IchiroKawashima/LSI-Design-Contest-2019/(threads)

Thread 15 (2019-02-01):

荷重値のクリッピング処理時のビット幅

IchiroKawashima, 2019-02-01:
https://github.com/IchiroKawashima/LSI-Design-Contest-2019/blob/edfe113395e68d94f4d649f5600b7f1a6fbd2dda/src/Network/Element/BiasWeight.v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

`w_weight`のビット幅と`w_weight_clp`のビット幅が逆になっている．

Closed 2019-02-01.

Thread 16 (2019-02-09):

Invalid bitwidth in Test modules

IchiroKawashima, 2019-02-09:
https://github.com/IchiroKawashima/LSI-Design-Contest-2019/blob/87d925d65bb4008e688236b019547710cd2cedb8/test/StreamSource.v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

https://github.com/IchiroKawashima/LSI-Design-Contest-2019/blob/87d925d65bb4008e688236b019547710cd2cedb8/test/StreamSink.v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

適切なビット幅は`[$clog2(SIZE+1)-1:0]`である．
