IchiroKawashima/LSI-Design-Contest-2019/src/Network/Layer/HiddenLayer.v

module HiddenLayer #
( parameter NP    = 8
, parameter NC    = 7
, parameter NN    = 6
, parameter WV    = 5
, parameter SEED  = 123456789
, parameter BURST = "yes"
)
( input                 iMode
, input        [WV-1:0] iLR
, input                 iValid_AM_State0
, output                oReady_AM_State0
, input     [NP*WV-1:0] iData_AM_State0
, input                 iValid_AS_State1
, output                oReady_AS_State1
, input     [NP*WV-1:0] iData_AS_State1
, output                oValid_BM_State0
, input                 iReady_BM_State0
, output    [NC*WV-1:0] oData_BM_State0
, output                oValid_BM_State1
, input                 iReady_BM_State1
, output    [NC*WV-1:0] oData_BM_State1
, input                 iValid_AM_Weight
, output                oReady_AM_Weight
, input  [NC*NN*WV-1:0] iData_AM_Weight
, output                oValid_BM_Weight
, input                 iReady_BM_Weight
, output [NP*NC*WV-1:0] oData_BM_Weight
, input                 iValid_AM_Delta0
, output                oReady_AM_Delta0
, input     [NN*WV-1:0] iData_AM_Delta0
, output                oValid_BM_Delta0
, input                 iReady_BM_Delta0
, output    [NC*WV-1:0] oData_BM_Delta0
, input                 iRST
, input                 iCLK
);

wire                            wvld_Accum0;
wire                            wrdy_Accum0;
wire [NC*($clog2(NP)+1+WV)-1:0] wdata_Accum0;
wire                            wvld_Accum1;
wire                            wrdy_Accum1;
wire [NC*($clog2(NP)+1+WV)-1:0] wdata_Accum1;
wire                            wvld_Accum2;
wire                            wrdy_Accum2;
wire   [NC*($clog2(NN)+WV)-1:0] wdata_Accum2;
wire                            wvld_WeightBias;
wire                            wrdy_WeightBias;
wire       [NC*NP*WV+NC*WV-1:0] wdata_WeightBias;
wire                            wvld_Delta1;
wire                            wrdy_Delta1;
wire                [NC*WV-1:0] wdata_Delta1;

ForwardMaccum #
( .NP(NP)
, .NC(NC)
, .WV(WV)
, .BURST(BURST)
) fm
( .iMode(iMode)
, .iValid_AM_WeightBias(wvld_WeightBias)
, .oReady_AM_WeightBias(wrdy_WeightBias)
, .iData_AM_WeightBias(wdata_WeightBias)
, .iValid_AM_State0(iValid_AM_State0)
, .oReady_AM_State0(oReady_AM_State0)
, .iData_AM_State0(iData_AM_State0)
, .oValid_BM_Accum0(wvld_Accum0)
, .iReady_BM_Accum0(wrdy_Accum0)
, .oData_BM_Accum0(wdata_Accum0)
, .oValid_BM_Accum1(wvld_Accum1)
, .iReady_BM_Accum1(wrdy_Accum1)
, .oData_BM_Accum1(wdata_Accum1)
, .iRST(iRST)
, .iCLK(iCLK)
);

Neuron #
( .HIDDEN("yes")
, .NP(NP)
, .NC(NC)
, .WV(WV)
, .BURST(BURST)
) ne
( .iMode(iMode)
, .iValid_AM_Accum0(wvld_Accum0)
, .oReady_AM_Accum0(wrdy_Accum0)
, .iData_AM_Accum0(wdata_Accum0)
, .oValid_BM_State0(oValid_BM_State0)
, .iReady_BM_State0(iReady_BM_State0)
, .oData_BM_State0(oData_BM_State0)
, .oValid_BM_State1(oValid_BM_State1)
, .iReady_BM_State1(iReady_BM_State1)
, .oData_BM_State1(oData_BM_State1)
, .iRST(iRST)
, .iCLK(iCLK)
);

BiasWeight #
( .NP(NP)
, .NC(NC)
, .WV(WV)
, .BURST(BURST)
, .SEED(SEED)
) bw
( .iMode(iMode)
, .iLR(iLR)
, .iValid_AS_State1(iValid_AS_State1)
, .oReady_AS_State1(oReady_AS_State1)
, .iData_AS_State1(iData_AS_State1)
, .iValid_AS_Delta1(wvld_Delta1)
, .oReady_AS_Delta1(wrdy_Delta1)
, .iData_AS_Delta1(wdata_Delta1)
, .oValid_BM_WeightBias(wvld_WeightBias)
, .iReady_BM_WeightBias(wrdy_WeightBias)
, .oData_BM_WeightBias(wdata_WeightBias)
, .oValid_BM_Weight(oValid_BM_Weight)
, .iReady_BM_Weight(iReady_BM_Weight)
, .oData_BM_Weight(oData_BM_Weight)
, .iRST(iRST)
, .iCLK(iCLK)
);

Delta #
( .HIDDEN("yes")
, .NP(NP)
, .NC(NC)
, .NN(NN)
, .WV(WV)
, .BURST(BURST)
) de
( .iValid_AS_Accum1(wvld_Accum1)
, .oReady_AS_Accum1(wrdy_Accum1)
, .iData_AS_Accum1(wdata_Accum1)
, .iValid_AS_Accum2(wvld_Accum2)
, .oReady_AS_Accum2(wrdy_Accum2)
, .iData_AS_Accum2(wdata_Accum2)
, .oValid_BM_Delta0(oValid_BM_Delta0)
, .iReady_BM_Delta0(iReady_BM_Delta0)
, .oData_BM_Delta0(oData_BM_Delta0)
, .oValid_BM_Delta1(wvld_Delta1)
, .iReady_BM_Delta1(wrdy_Delta1)
, .oData_BM_Delta1(wdata_Delta1)
, .iRST(iRST)
, .iCLK(iCLK)
);

BackwardMaccum #
( .NN(NN)
, .NC(NC)
, .WV(WV)
, .BURST(BURST)
) bm
( .iValid_AM_Weight(iValid_AM_Weight)
, .oReady_AM_Weight(oReady_AM_Weight)
, .iData_AM_Weight(iData_AM_Weight)
, .iValid_AM_Delta0(iValid_AM_Delta0)
, .oReady_AM_Delta0(oReady_AM_Delta0)
, .iData_AM_Delta0(iData_AM_Delta0)
, .oValid_BM_Accum2(wvld_Accum2)
, .iReady_BM_Accum2(wrdy_Accum2)
, .oData_BM_Accum2(wdata_Accum2)
, .iRST(iRST)
, .iCLK(iCLK)
);

endmodule
