IchiroKawashima/LSI-Design-Contest-2019/test/Basic/CollectorTest.v

`include "Test.vh"

module CollectorTest #
( parameter BURST    = "no"
, parameter PRIORITY = 0
);

ClockDomain c();

reg        iValid_AM0;
wire       oReady_AM0;
reg  [3:0] iData_AM0;
reg        iValid_AM1;
wire       oReady_AM1;
reg  [3:0] iData_AM1;
wire       oValid_BM;
reg        iReady_BM;
wire       oSelect_BM;
wire [7:0] oData_BM;

wire       wvld0;
wire       wrdy0;
wire [3:0] wdata0;
wire       wvld1;
wire       wrdy1;
wire [3:0] wdata1;

//Register
Register #
( .WIDTH(4)
, .BURST(BURST)
) rg0
( .iValid_AM(iValid_AM0)
, .oReady_AM(oReady_AM0)
, .iData_AM(iData_AM0)
, .oValid_BM(wvld0)
, .iReady_BM(wrdy0)
, .oData_BM(wdata0)
, .iRST(c.RST)
, .iCLK(c.CLK)
);

//Register
Register #
( .WIDTH(4)
, .BURST(BURST)
) rg1
( .iValid_AM(iValid_AM1)
, .oReady_AM(oReady_AM1)
, .iData_AM(iData_AM1)
, .oValid_BM(wvld1)
, .iReady_BM(wrdy1)
, .oData_BM(wdata1)
, .iRST(c.RST)
, .iCLK(c.CLK)
);

Collector #
( .WIDTH0(4)
, .WIDTH1(4)
, .PRIORITY(PRIORITY)
) collector
( .iValid_AS0(wvld0)
, .oReady_AS0(wrdy0)
, .iData_AS0(wdata0)
, .iValid_AS1(wvld1)
, .oReady_AS1(wrdy1)
, .iData_AS1(wdata1)
, .oValid_BM(oValid_BM)
, .iReady_BM(iReady_BM)
, .oSelect_BM(oSelect_BM)
, .oData_BM(oData_BM)
);

`DUMP_ALL("cl.vcd")
`SET_LIMIT(c, 30)

initial begin
    @(c.eCLK) begin
        iValid_AM0 = 1'b0;
        iValid_AM1 = 1'b0;
        iData_AM0  = 4'h0;
        iData_AM1  = 4'h0;
        iReady_BM  = 1'b0;
    end

    //Case0
    @(c.eCLK) begin
        iValid_AM0 = 1'b1;
        iValid_AM1 = 1'b0;
        iData_AM0  = 4'ha;
        iData_AM1  = 4'h0;
        iReady_BM  = 1'b1;
    end

    @(c.eCLK) begin
        iValid_AM0 = 1'b0;
        iValid_AM1 = 1'b0;
        iData_AM0  = 4'h0;
        iData_AM1  = 4'h0;
        iReady_BM  = 1'b1;
    end

    `WAIT_UNTIL(c, oReady_AM0 === 1'b1 && oReady_AM1 === 1'b1)

    //Case1
    @(c.eCLK) begin
        iValid_AM0 = 1'b0;
        iValid_AM1 = 1'b1;
        iData_AM0  = 4'h0;
        iData_AM1  = 4'hb;
        iReady_BM  = 1'b1;
    end

    @(c.eCLK) begin
        iValid_AM0 = 1'b0;
        iValid_AM1 = 1'b0;
        iData_AM0  = 4'h0;
        iData_AM1  = 4'h0;
        iReady_BM  = 1'b1;
    end

    `WAIT_UNTIL(c, oReady_AM0 === 1'b1 && oReady_AM1 === 1'b1)

    //Case2
    @(c.eCLK) begin
        iValid_AM0 = 1'b1;
        iValid_AM1 = 1'b1;
        iData_AM0  = 4'h7;
        iData_AM1  = 4'h8;
        iReady_BM  = 1'b0;
    end

    @(c.eCLK) begin
        iValid_AM0 = 1'b0;
        iValid_AM1 = 1'b0;
        iData_AM0  = 4'h0;
        iData_AM1  = 4'h0;
        iReady_BM  = 1'b1;
    end

    @(c.eCLK) begin
        iValid_AM0 = 1'b0;
        iValid_AM1 = 1'b0;
        iData_AM0  = 4'h0;
        iData_AM1  = 4'h0;
        iReady_BM  = 1'b0;
    end

    `WAIT_FOR(c, 2)

    @(c.eCLK) begin
        iValid_AM0 = 1'b0;
        iValid_AM1 = 1'b0;
        iData_AM0  = 4'h0;
        iData_AM1  = 4'h0;
        iReady_BM  = 1'b1;
    end

    `WAIT_UNTIL(c, oReady_AM0 === 1'b1 && oReady_AM1 === 1'b1)

    //Case3
    @(c.eCLK) begin
        iValid_AM0 = 1'b1;
        iValid_AM1 = 1'b0;
        iData_AM0  = 4'h4;
        iData_AM1  = 4'h0;
        iReady_BM  = 1'b0;
    end

    `WAIT_FOR(c, 2)

    @(c.eCLK) begin
        iValid_AM0 = 1'b0;
        iValid_AM1 = 1'b1;
        iData_AM0  = 4'h0;
        iData_AM1  = 4'h5;
        iReady_BM  = 1'b0;
    end

    @(c.eCLK) begin
        iValid_AM0 = 1'b0;
        iValid_AM1 = 1'b0;
        iData_AM0  = 4'h0;
        iData_AM1  = 4'h0;
        iReady_BM  = 1'b1;
    end

    `WAIT_UNTIL(c, oReady_AM0 === 1'b1 && oReady_AM1 === 1'b1)

    //Case4
    @(c.eCLK) begin
        iValid_AM0 = 1'b1;
        iValid_AM1 = 1'b0;
        iData_AM0  = 4'h1;
        iData_AM1  = 4'h0;
        iReady_BM  = 1'b1;
    end

    @(c.eCLK) begin
        iValid_AM0 = 1'b0;
        iValid_AM1 = 1'b1;
        iData_AM0  = 4'h0;
        iData_AM1  = 4'h2;
        iReady_BM  = 1'b1;
    end

    @(c.eCLK) begin
        iValid_AM0 = 1'b1;
        iValid_AM1 = 1'b0;
        iData_AM0  = 4'h3;
        iData_AM1  = 4'h0;
        iReady_BM  = 1'b1;
    end

    @(c.eCLK) begin
        iValid_AM0 = 1'b1;
        iValid_AM1 = 1'b0;
        iData_AM0  = 4'h4;
        iData_AM1  = 4'h0;
        iReady_BM  = 1'b1;
    end

    `WAIT_FOR(c, 1)

    @(c.eCLK)
        $finish;
end

endmodule
