IchiroKawashima/LSI-Design-Contest-2019/(commit log)

2019-01-29 fix mistakes for compile
    [BackwardMaccum.v, BiasWeight.v, Delta.v, ForwardMaccum.v, HiddenLayer.v, Maccum.v, Network.v, NetworkTest.v]
2019-02-01 fix enable condition of StreamSource
    [StreamSource.v]
2019-02-01 fix bitwidth of substitution
    [Delta.v, Neuron.v]
2019-02-01 fix bitwidth of w_weight and w_weight_clp close #15
    [BiasWeight.v]
